BigBoatEnergy/BoatCAD/README.md

# Boat Robot

Robot Boats are hard. this may help someone.

-keith
