BigBoatEnergy/BoatCAD/cad/README.md

# CAD Files for Boat Robot

This contains all the models and STLs for the various parts printed during the
project.
