BigBoatEnergy/BoatCAD/cad/hull/README.md

# Hull Prototype

Prototype hull that we originally thought about printing, but decided against due to exorbitant cost.
