BigBoatEnergy/BoatCAD/cad/foam_model_mockup/foam plank dowel holders - main holders.stl

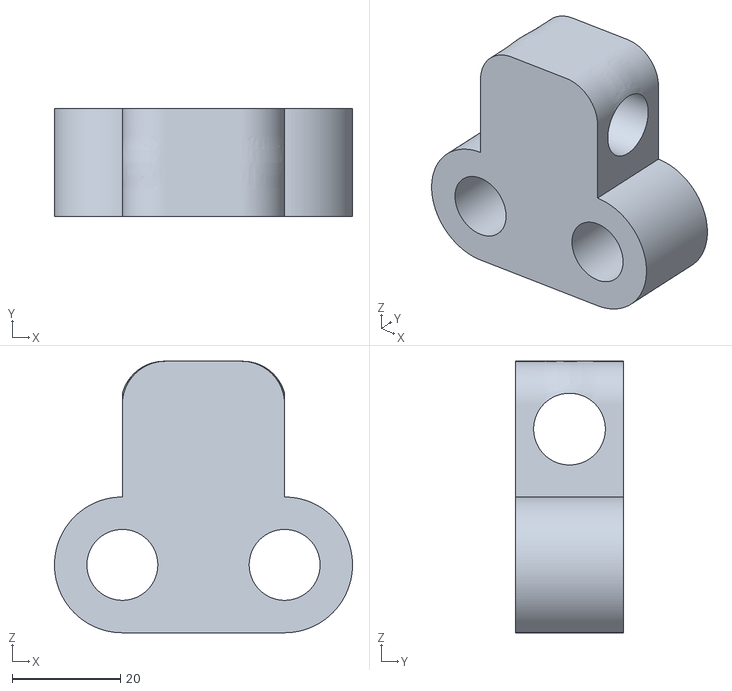
[picture p1: CAD file, 2023-07-22]
cad/foam_model_mockup/foam plank dowel holders - main holders.stl
55.1 x 20.0 x 50.2
