BigBoatEnergy/BoatCAD/cad/Antena_Slew_Ring/Antenna Slew Ring-Shaft Mounted Gearshaft mount.stl

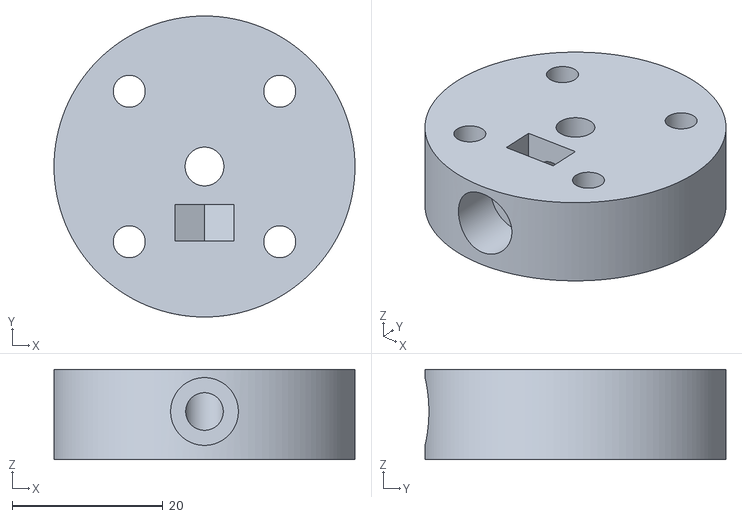
[picture p2: CAD file, 2024-01-04]
cad/Antena_Slew_Ring/Antenna Slew Ring-Shaft Mounted Gearshaft mount.stl
40.0 x 40.0 x 12.0
