BigBoatEnergy/BoatCAD/cad/beaglebone_blue/beaglebone Blue to pelican case.stl

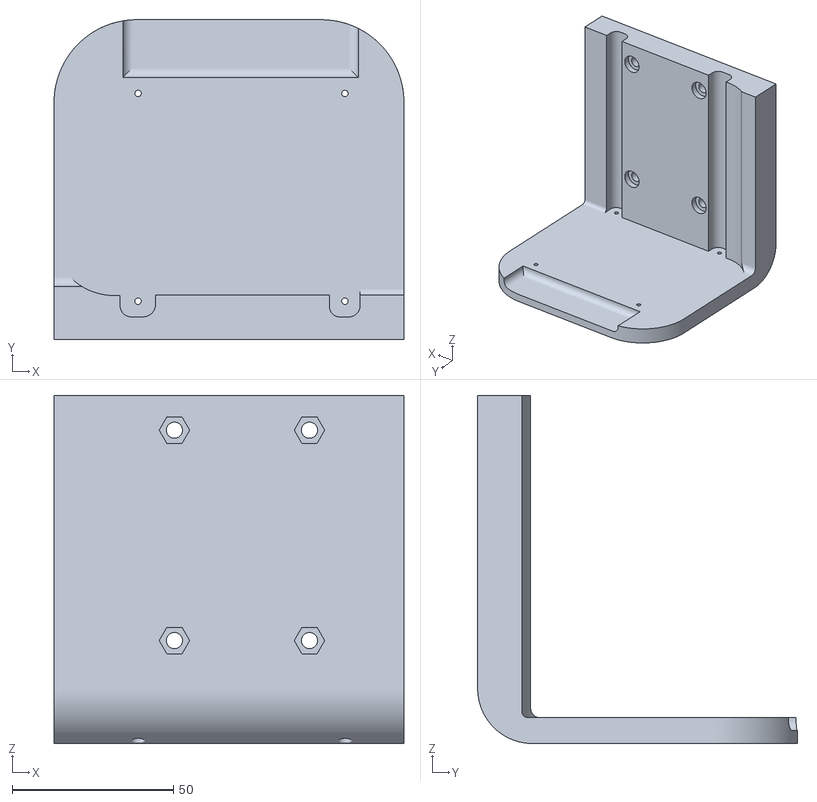
[picture p3: CAD file, 2023-07-22]
cad/beaglebone_blue/beaglebone Blue to pelican case.stl
108.6 x 99.2 x 108.0
