BigBoatEnergy/BoatCAD/cad/beaglebone_blue/beaglebone_blue_case/beaglebone Blue Case.FCStd

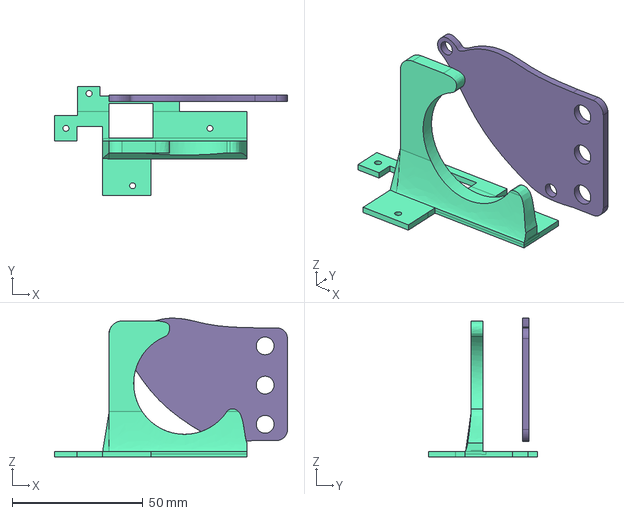
[picture p4: CAD file, 2023-07-17]
cad/beaglebone_blue/beaglebone_blue_case/beaglebone Blue Case.FCStd
89.1 x 41.7 x 53.1 mm
fan holder corrected
Antena Holder
