BigBoatEnergy/BoatCAD/cad/dowel_holder/Dowel holder-top dowel mount.stl

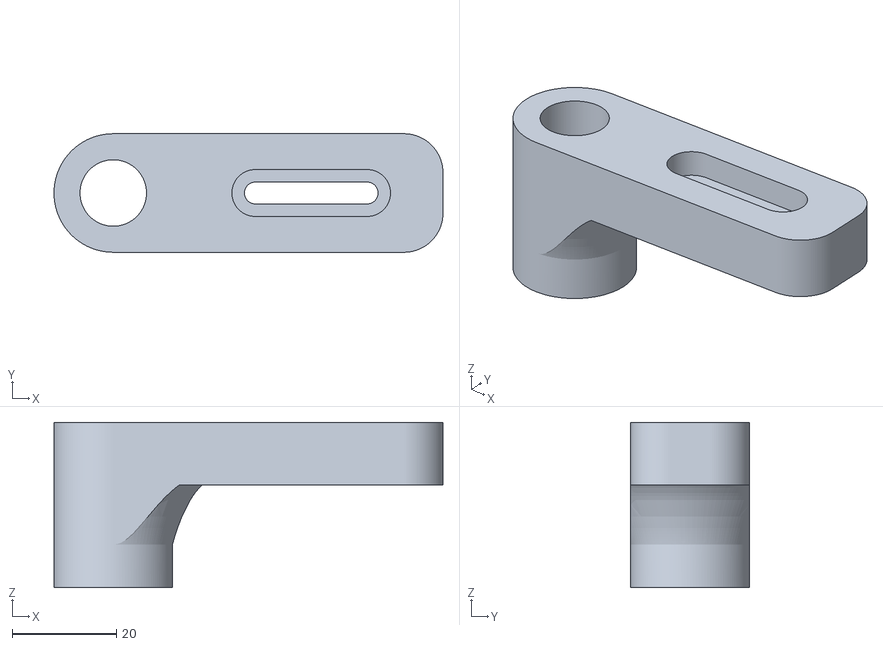
[picture p5: CAD file, 2023-07-14]
cad/dowel_holder/Dowel holder-top dowel mount.stl
74.6 x 22.8 x 31.8
