BigBoatEnergy/BoatCAD/cad/foam_model_mockup/foam plank dowel holders.FCStd

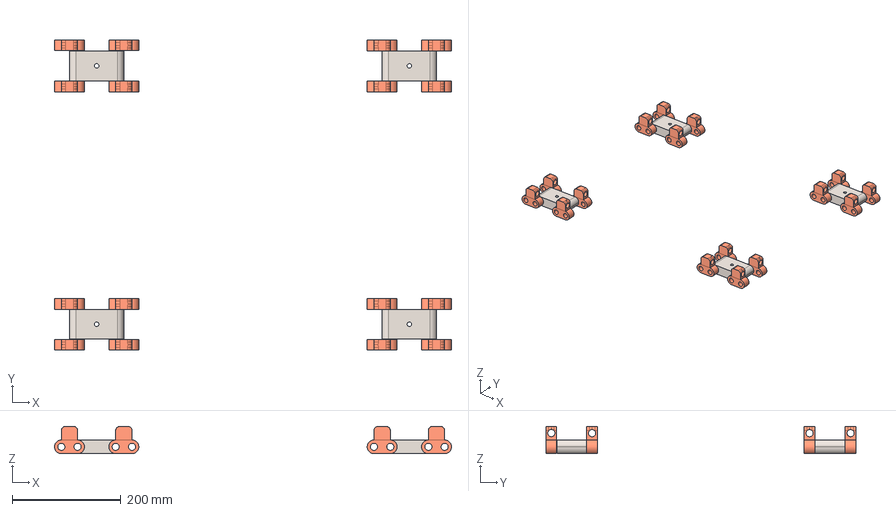
[picture p6: CAD file, 2023-07-22]
cad/foam_model_mockup/foam plank dowel holders.FCStd
730.1 x 570.6 x 50.2 mm
main mount points
ready rod adapters
