BigBoatEnergy/BoatCAD/cad/Heat Sync adapter plate/Heat sync adapter.FCStd

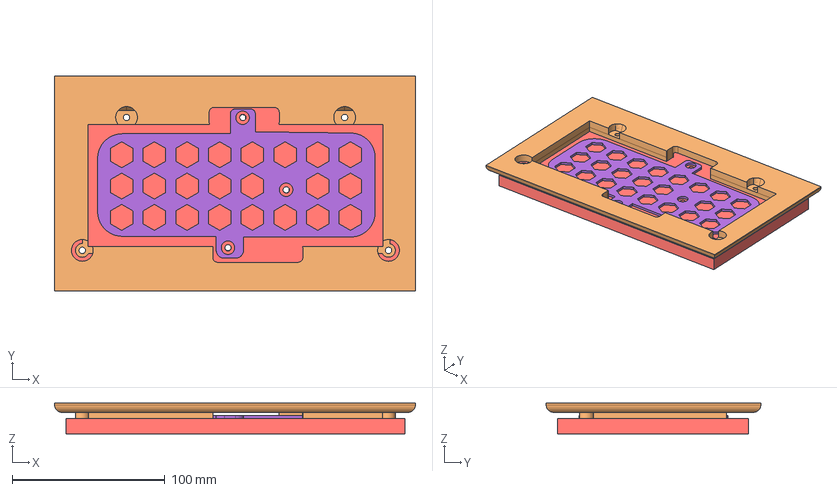
[picture p7: CAD file, 2024-01-04]
cad/Heat Sync adapter plate/Heat sync adapter.FCStd
236.4 x 140.6 x 20.0 mm
blank heat sync
esc hold down
