BigBoatEnergy/BoatCAD/cad/hull/boatymcrobotface.FCStd

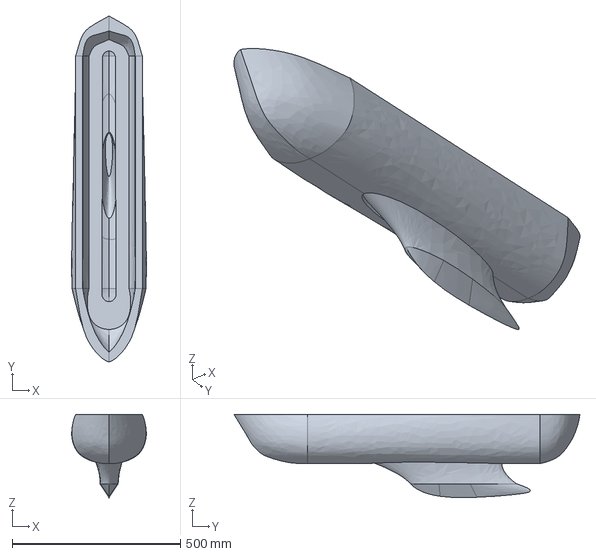
[picture p8: CAD file, 2023-07-14]
cad/hull/boatymcrobotface.FCStd
221.7 x 1028.0 x 247.2 mm
