BigBoatEnergy/BoatCAD/cad/pixhawk propper orientation fix/base.stl

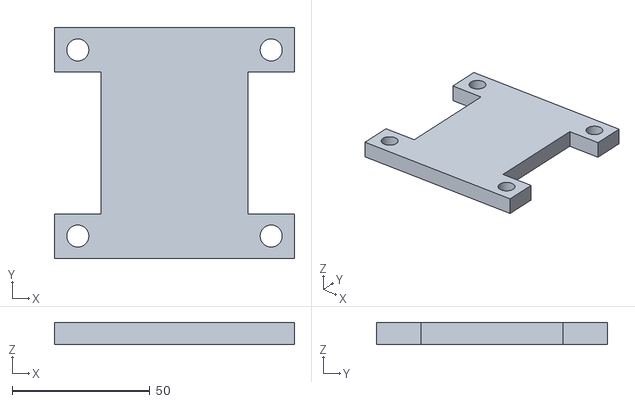
[picture p9: CAD file, 2024-01-04]
cad/pixhawk propper orientation fix/base.stl
87.2 x 83.8 x 8.00
