BigBoatEnergy/BoatCAD/cad/servo_motor_interface/Servo motor interface-mount to hull.stl

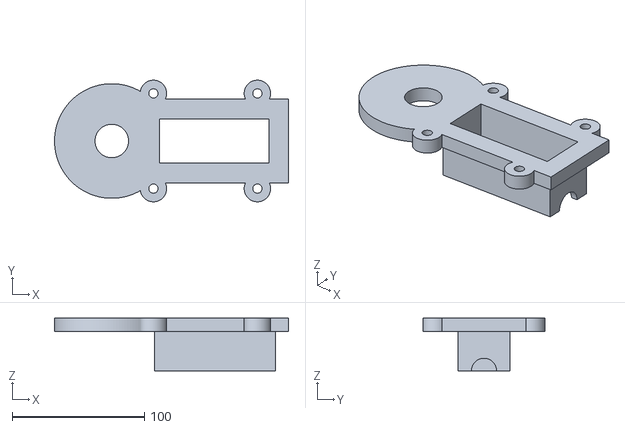
[picture p10: CAD file, 2023-07-22]
cad/servo_motor_interface/Servo motor interface-mount to hull.stl
177.2 x 92.1 x 40.0
