BigBoatEnergy/BoatCAD/Servo motor interface.FCStd

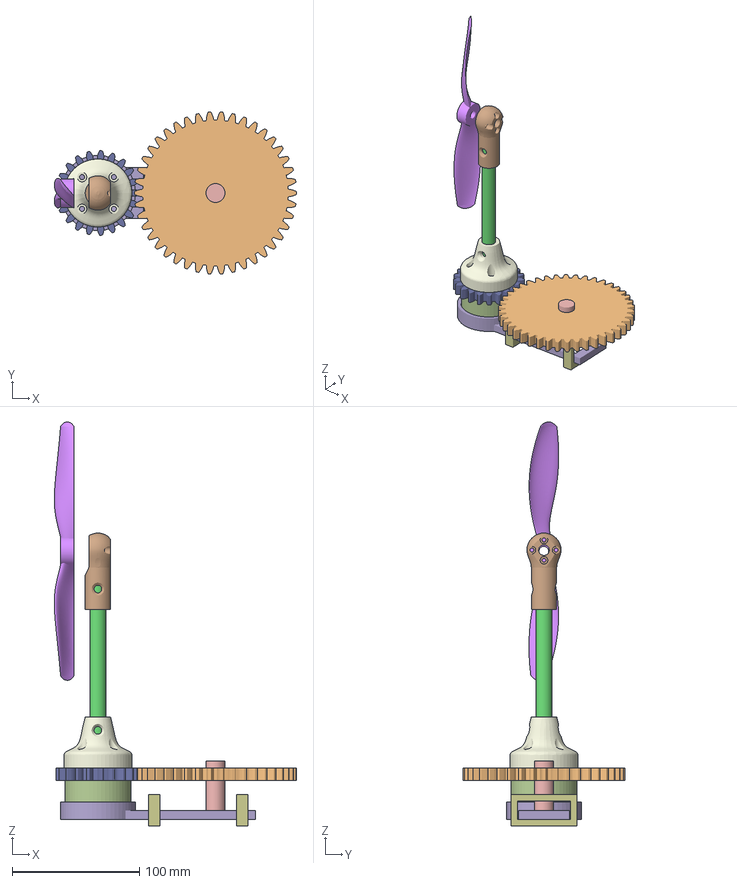
[picture p11: CAD file, 2023-07-15]
Servo motor interface.FCStd
190.4 x 127.4 x 317.5 mm
DRIVE GEAR
DRIVEN GEAR
BASE
TOP
brushless motor holder
propeller
