BigBoatEnergy/BoatCAD/cad/Antena_Slew_Ring/Antenna Slew Ring-bottom bearing body.stl

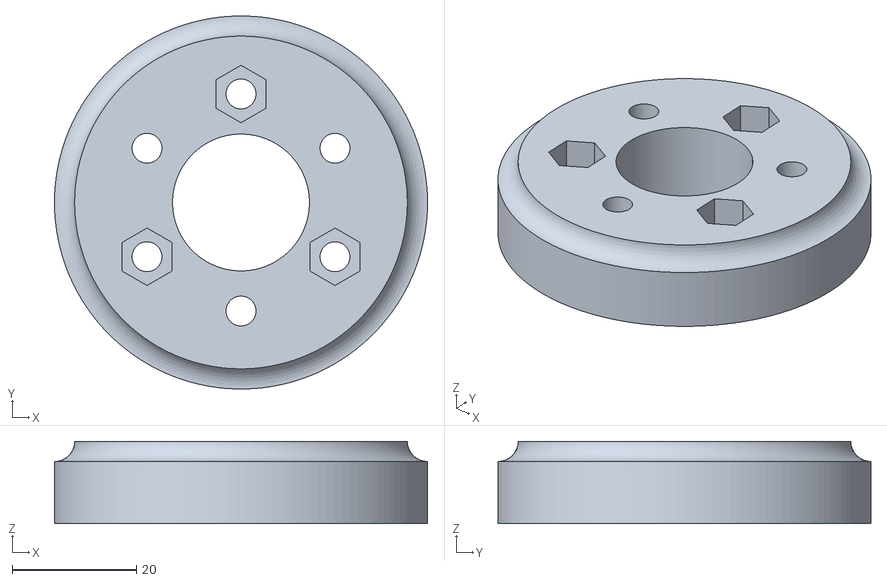
[picture p12: CAD file, 2024-01-04]
cad/Antena_Slew_Ring/Antenna Slew Ring-bottom bearing body.stl
60.0 x 60.0 x 13.3
