BigBoatEnergy/BoatCAD/cad/beaglebone_blue/beaglebone Blue Case-lid.stl

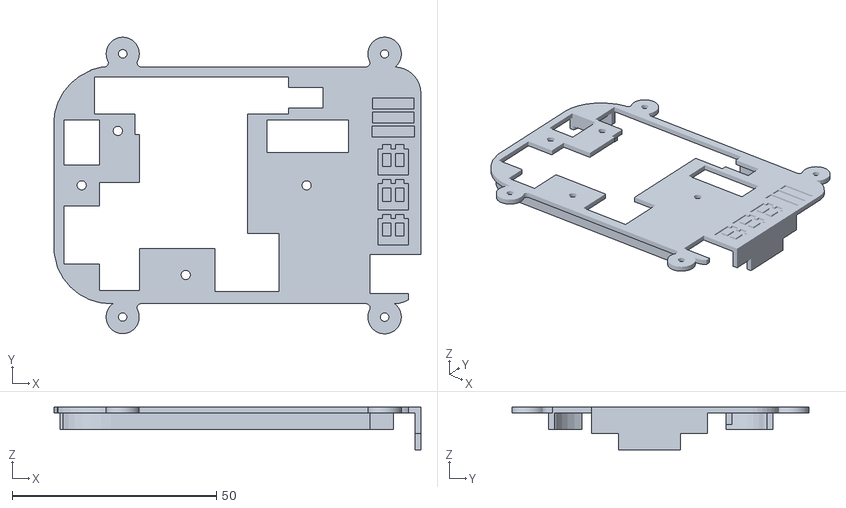
[picture p13: CAD file, 2023-07-17]
cad/beaglebone_blue/beaglebone Blue Case-lid.stl
89.9 x 72.7 x 10.5
