BigBoatEnergy/BoatCAD/cad/dowel_holder/Dowel holder.FCStd

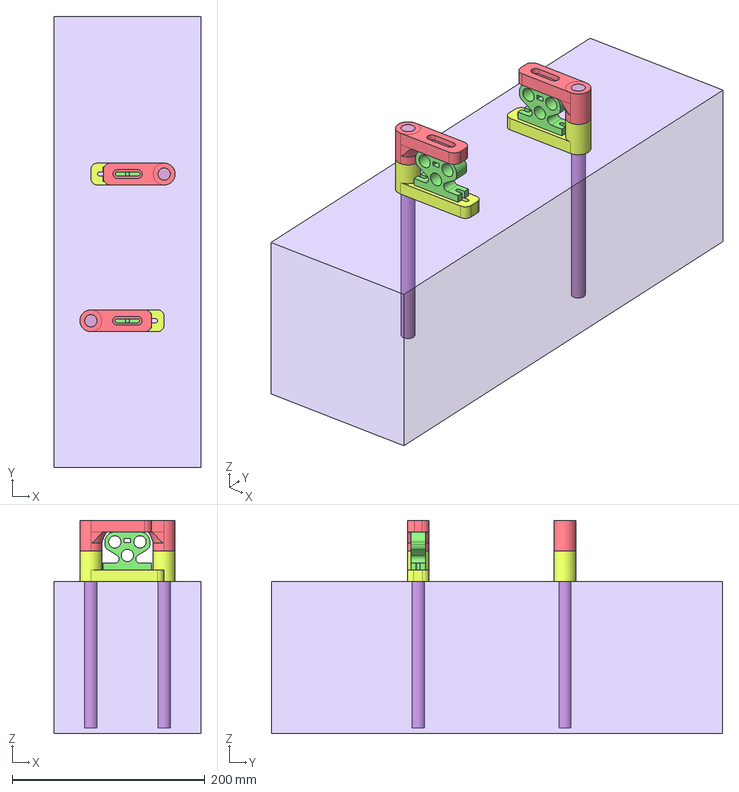
[picture p14: CAD file, 2023-07-14]
cad/dowel_holder/Dowel holder.FCStd
152.4 x 468.4 x 221.5 mm
Support dowel 1
boat hull mock up
Support dowel 2
top dowel mount
bottom dowel mount
3 rod holder
3 rod holder001
top dowel mount001
bottom dowel mount001
