BigBoatEnergy/BoatCAD/cad/foam_model_mockup/foam plank dowel holders - ready rod adapters.stl

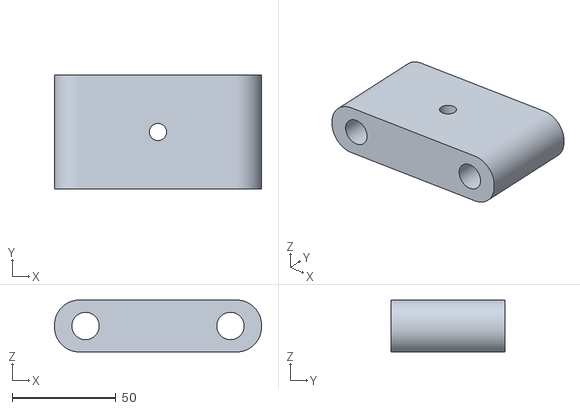
[picture p15: CAD file, 2023-07-22]
cad/foam_model_mockup/foam plank dowel holders - ready rod adapters.stl
100.0 x 55.1 x 25.1
