BigBoatEnergy/BoatCAD/cad/pixhawk propper orientation fix/top.stl

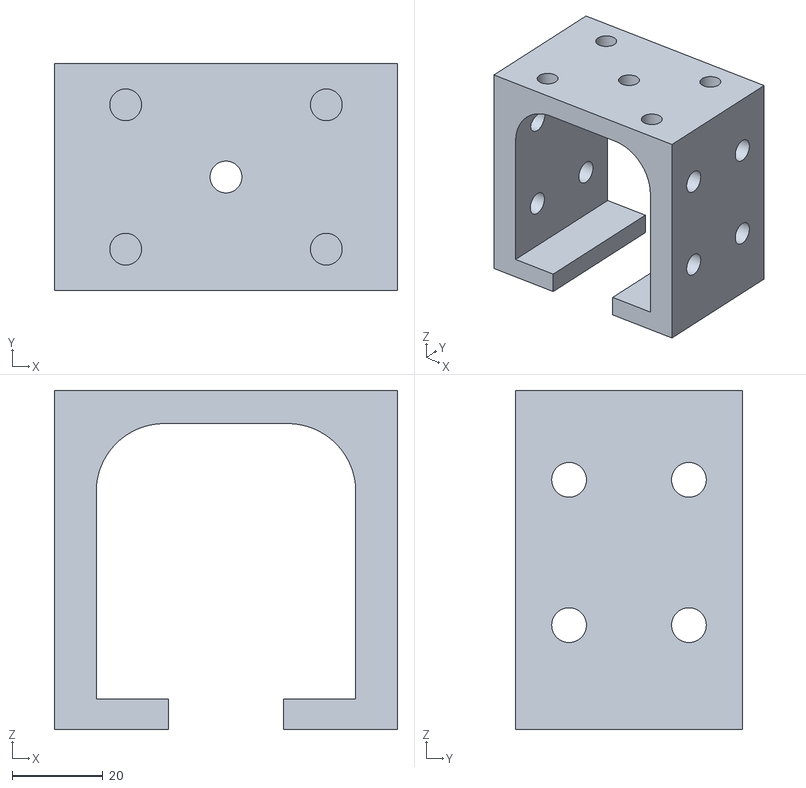
[picture p16: CAD file, 2024-01-04]
cad/pixhawk propper orientation fix/top.stl
75.5 x 50.0 x 74.7
