BigBoatEnergy/BoatCAD/cad/servo_motor_interface/Servo motor interface-brushless motor holder.stl

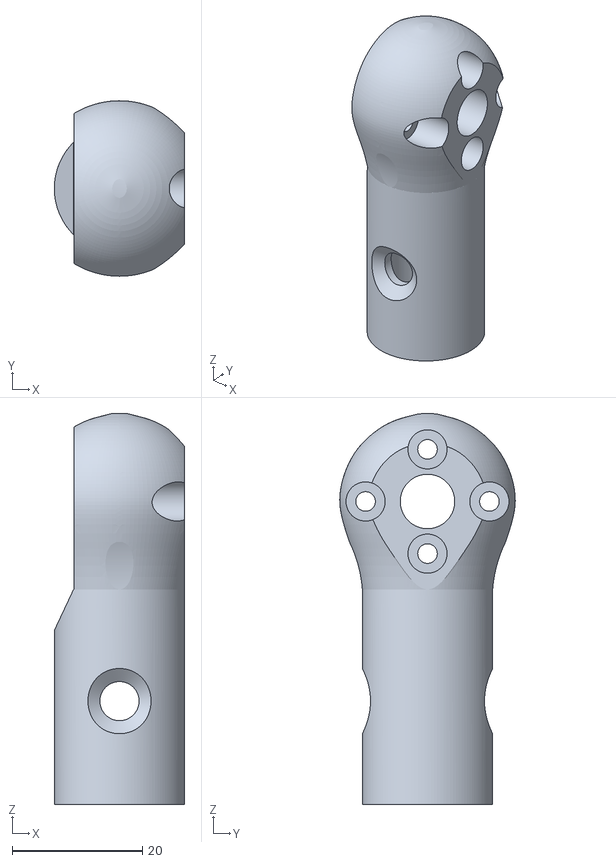
[picture p17: CAD file, 2023-07-17]
cad/servo_motor_interface/Servo motor interface-brushless motor holder.stl
20.0 x 26.9 x 60.0
