BigBoatEnergy/BoatCAD/cad/Antena_Slew_Ring/Antenna Slew Ring-base and side cover.stl

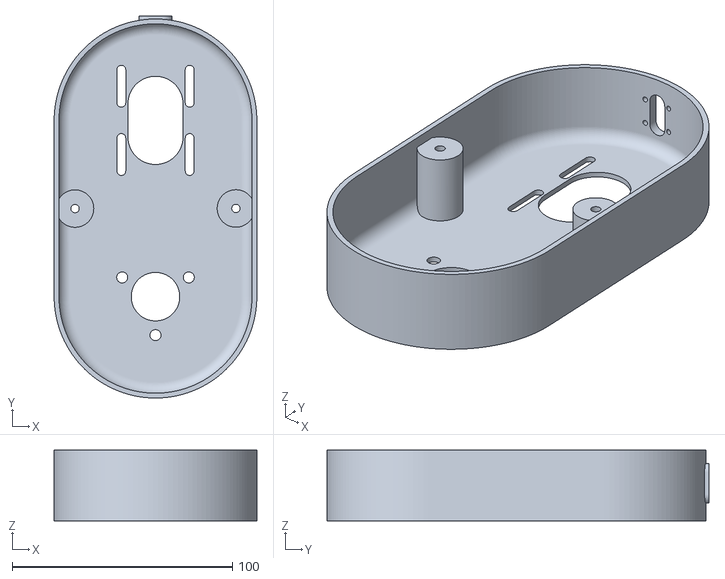
[picture p18: CAD file, 2024-01-04]
cad/Antena_Slew_Ring/Antenna Slew Ring-base and side cover.stl
92.0 x 173.4 x 32.0
