BigBoatEnergy/BoatCAD/cad/beaglebone_blue/beaglebone Blue Case-base.stl

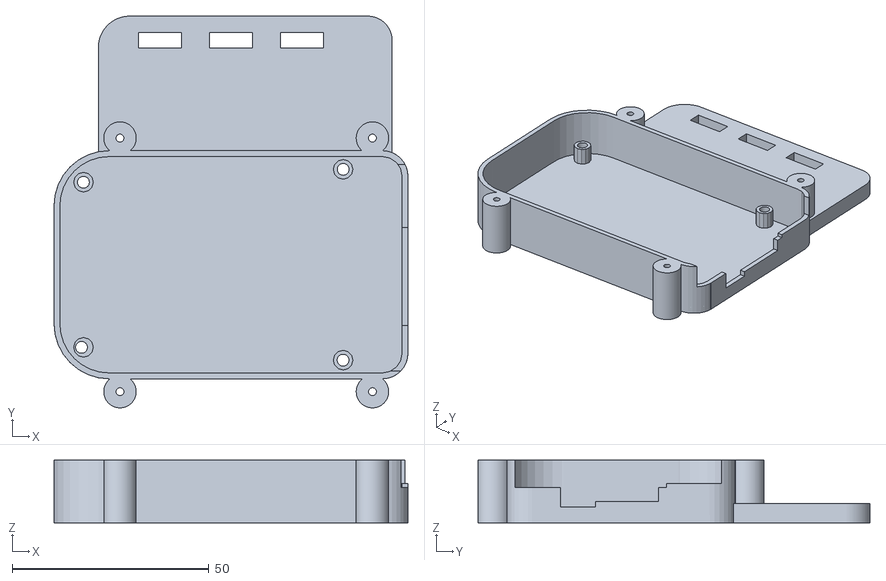
[picture p19: CAD file, 2023-07-17]
cad/beaglebone_blue/beaglebone Blue Case-base.stl
90.0 x 99.6 x 16.0
