BigBoatEnergy/BoatCAD/cad/dowel_holder/Dowel holder-3 rod holder.stl

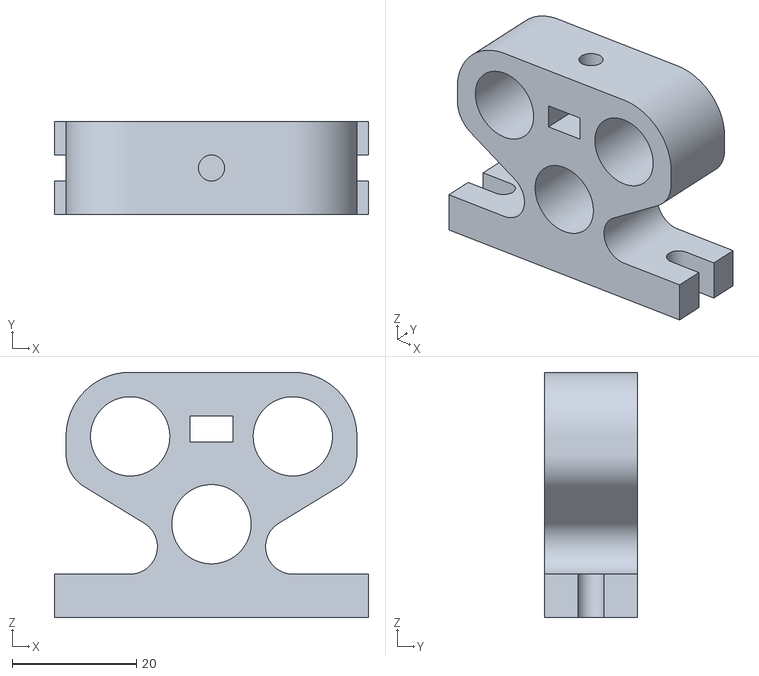
[picture p20: CAD file, 2023-07-14]
cad/dowel_holder/Dowel holder-3 rod holder.stl
50.5 x 15.0 x 39.5
