BigBoatEnergy/BoatCAD/cad/hull/boatymcrobotface-Fusion.stl

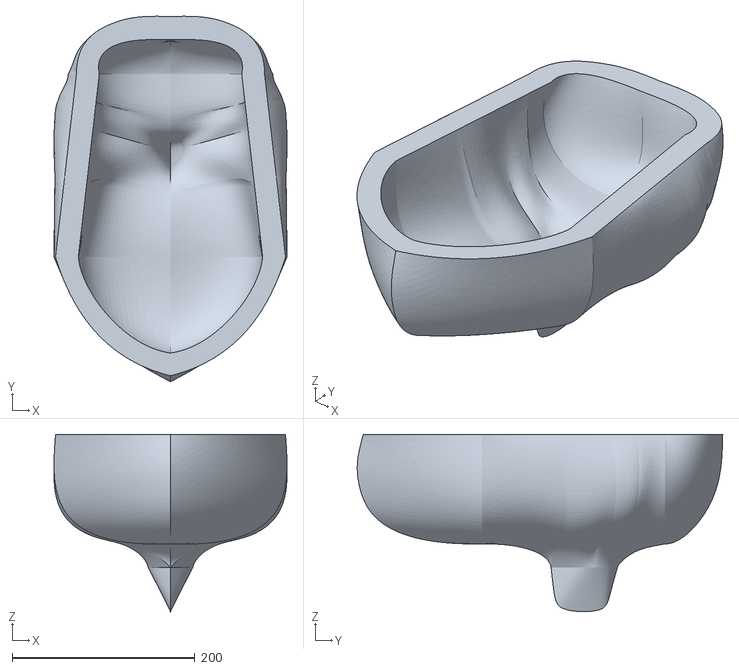
[picture p21: CAD file, 2023-07-01]
cad/hull/boatymcrobotface-Fusion.stl
254.9 x 399.9 x 193.9
