BigBoatEnergy/BoatCAD/cad/pixhawk propper orientation fix/orientation fix.FCStd

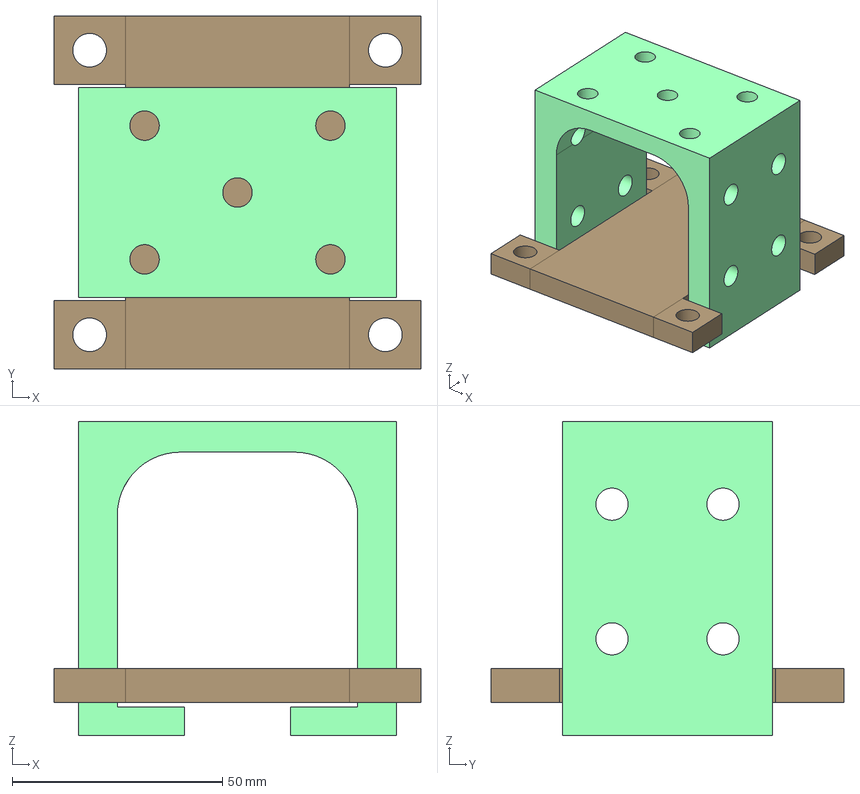
[picture p22: CAD file, 2024-01-04]
cad/pixhawk propper orientation fix/orientation fix.FCStd
87.2 x 83.8 x 74.7 mm
