BigBoatEnergy/BoatCAD/cad/servo_motor_interface/Servo motor interface-servo holder.stl

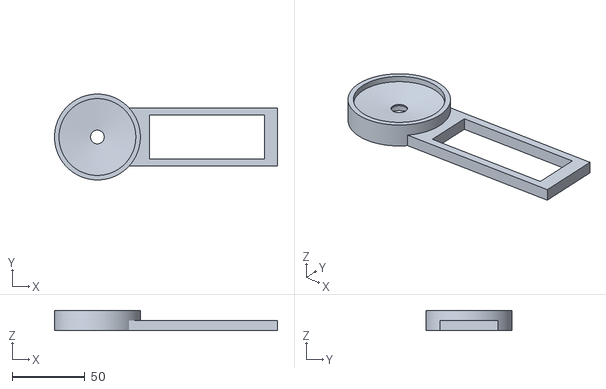
[picture p23: CAD file, 2023-07-15]
cad/servo_motor_interface/Servo motor interface-servo holder.stl
153.4 x 59.1 x 13.9
