BigBoatEnergy/BoatCAD/cad/Antena_Slew_Ring/Antenna Slew Ring-driven gear.stl

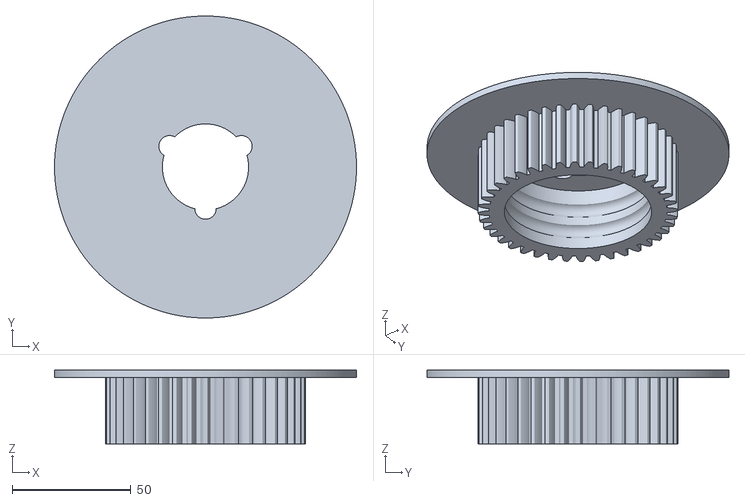
[picture p24: CAD file, 2024-01-04]
cad/Antena_Slew_Ring/Antenna Slew Ring-driven gear.stl
127.1 x 127.1 x 31.0
