BigBoatEnergy/BoatCAD/cad/beaglebone_blue/beaglebone Blue Case-antenna holder.stl

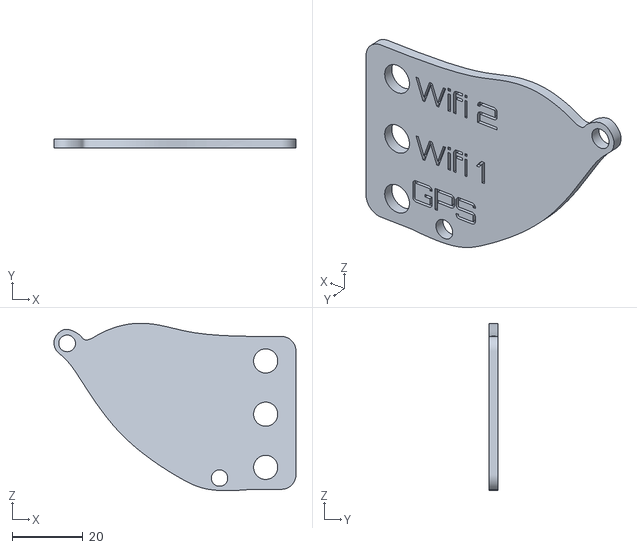
[picture p25: CAD file, 2023-07-17]
cad/beaglebone_blue/beaglebone Blue Case-antenna holder.stl
68.2 x 2.50 x 47.2
