BigBoatEnergy/BoatCAD/cad/dowel_holder/Dowel holder-bottom dowel mount.stl

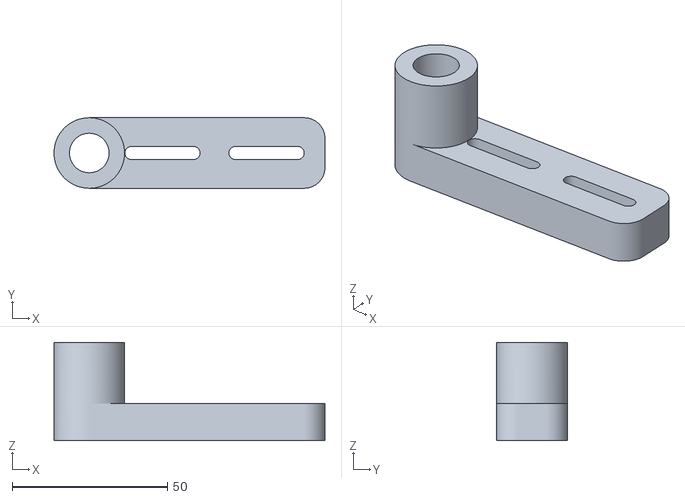
[picture p26: CAD file, 2023-07-14]
cad/dowel_holder/Dowel holder-bottom dowel mount.stl
87.4 x 22.8 x 31.8
