BigBoatEnergy/BoatCAD/cad/foam_model_mockup/foam model mockup.FCStd

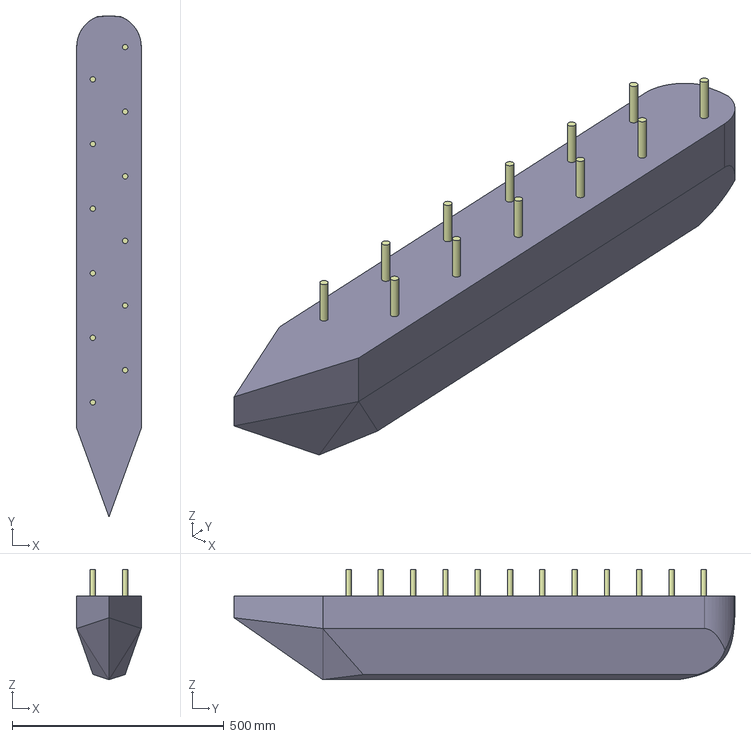
[picture p27: CAD file, 2023-07-14]
cad/foam_model_mockup/foam model mockup.FCStd
152.4 x 1181.7 x 260.4 mm
