BigBoatEnergy/BoatCAD/cad/servo_motor_interface/Servo motor interface-TOP.stl

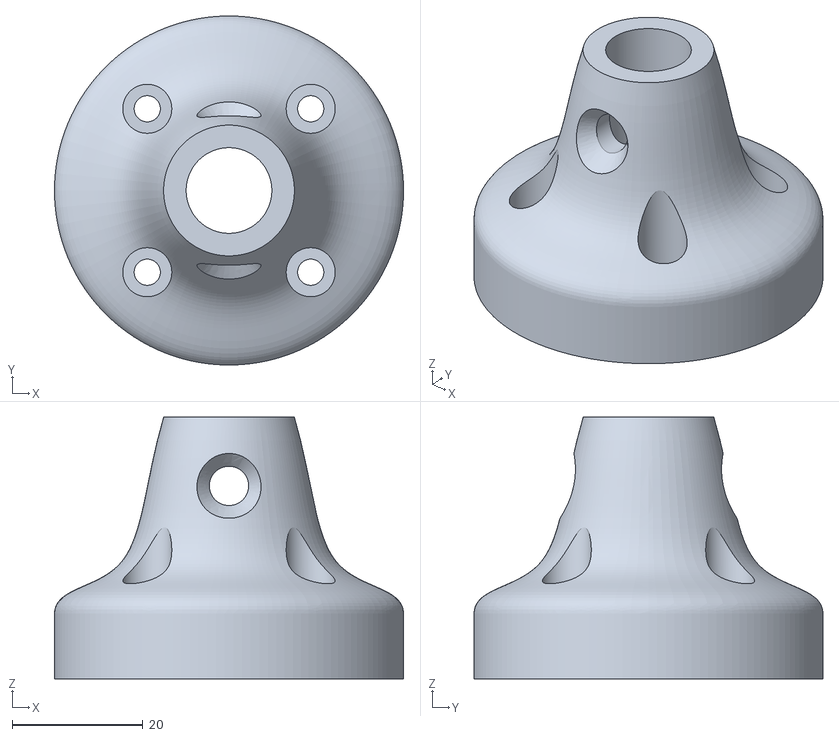
[picture p28: CAD file, 2023-07-15]
cad/servo_motor_interface/Servo motor interface-TOP.stl
53.4 x 53.4 x 40.0
