BigBoatEnergy/BoatCAD/cad/Antena_Slew_Ring/Antenna Slew Ring-Shaft Mounted GearGear.stl

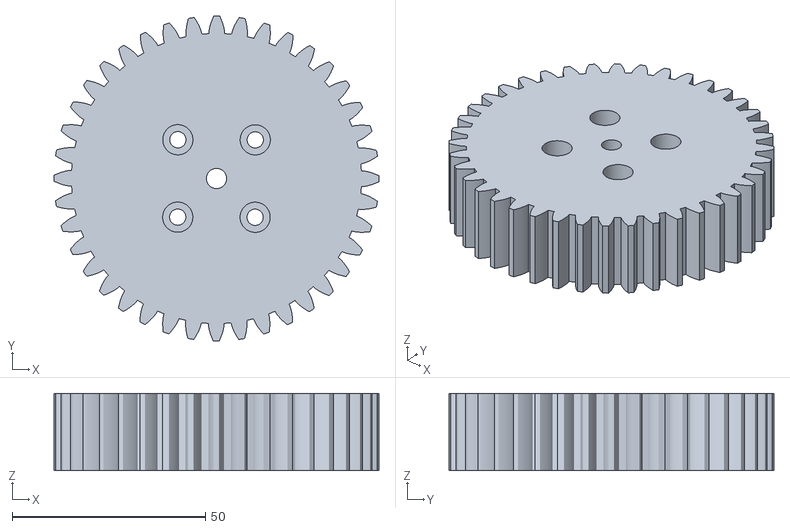
[picture p29: CAD file, 2024-01-04]
cad/Antena_Slew_Ring/Antenna Slew Ring-Shaft Mounted GearGear.stl
84.0 x 84.0 x 20.0
