BigBoatEnergy/BoatCAD/cad/beaglebone_blue/beaglebone Blue Case-fan holder.stl

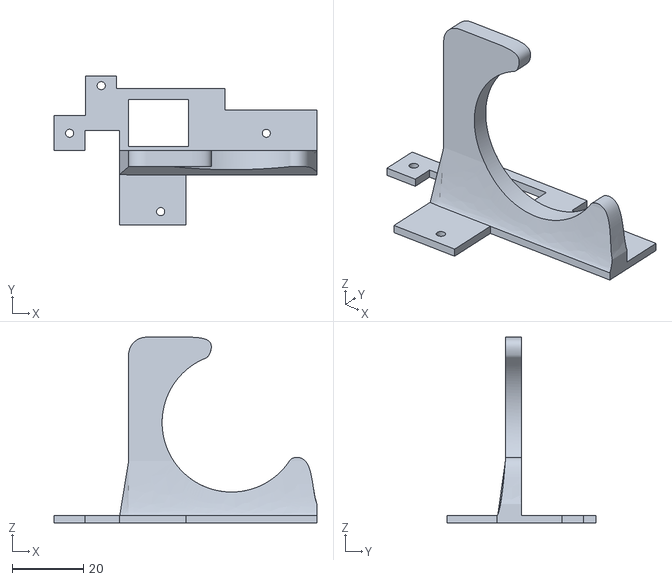
[picture p30: CAD file, 2023-07-17]
cad/beaglebone_blue/beaglebone Blue Case-fan holder.stl
73.7 x 41.7 x 52.0
