BigBoatEnergy/BoatCAD/cad/servo_motor_interface/Servo motor interface-DRIVEN GEAR.stl

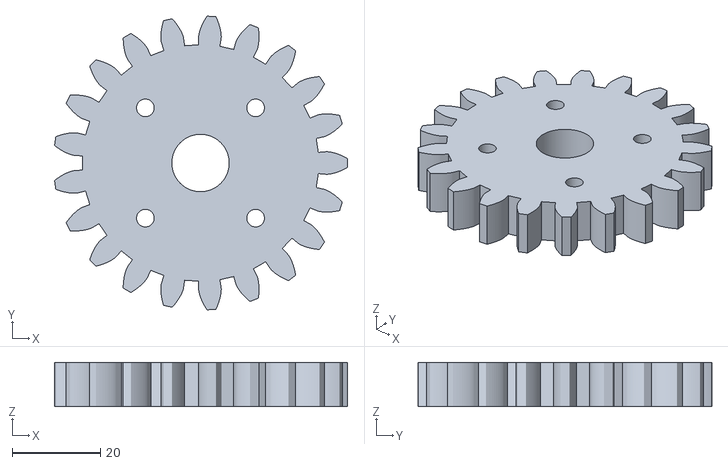
[picture p31: CAD file, 2023-07-15]
cad/servo_motor_interface/Servo motor interface-DRIVEN GEAR.stl
66.4 x 66.6 x 10.0
