BigBoatEnergy/BoatCAD/cad/Antena_Slew_Ring/Antenna Slew Ring.FCStd

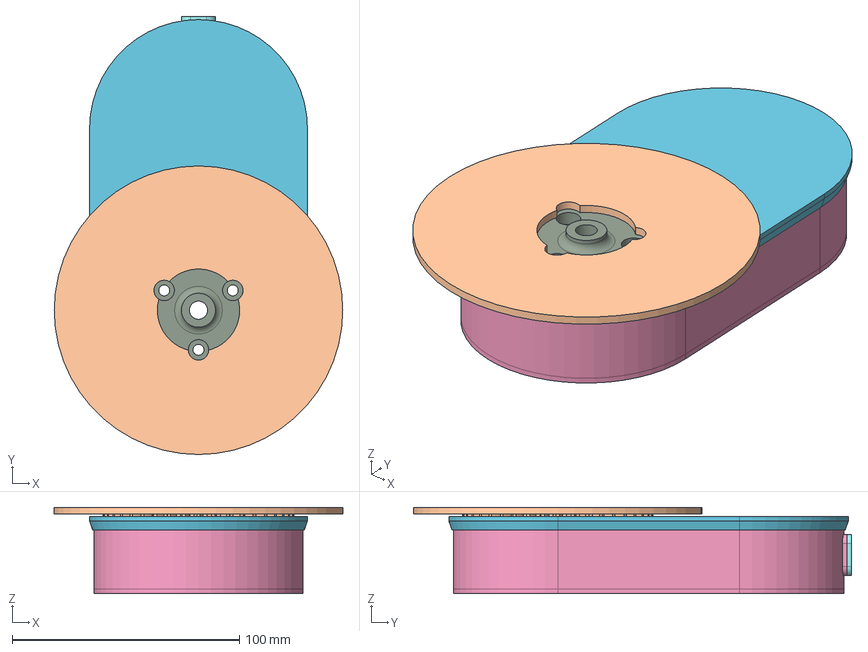
[picture p32: CAD file, 2024-01-04]
cad/Antena_Slew_Ring/Antenna Slew Ring.FCStd
127.1 x 192.9 x 38.0 mm
bottom bearing body
mid bearing body
top bearing body
driven gear
shaft mount
M4-Nut x 2
M4-Nut013 x 2
M4-Nut016 x 2
M4-Nut017 x 2
M5x12-Screw x 2
M5-Nut x 2
M4x16-Screw x 2
M4x16-Screw006 x 2
M4x16-Screw005 x 2
M4x16-Screw004 x 2
Gear x 2
base and side cover
Lid
allen bolt cover
