BigBoatEnergy/BoatCAD/cad/servo_motor_interface/Servo motor interface-BASE.stl

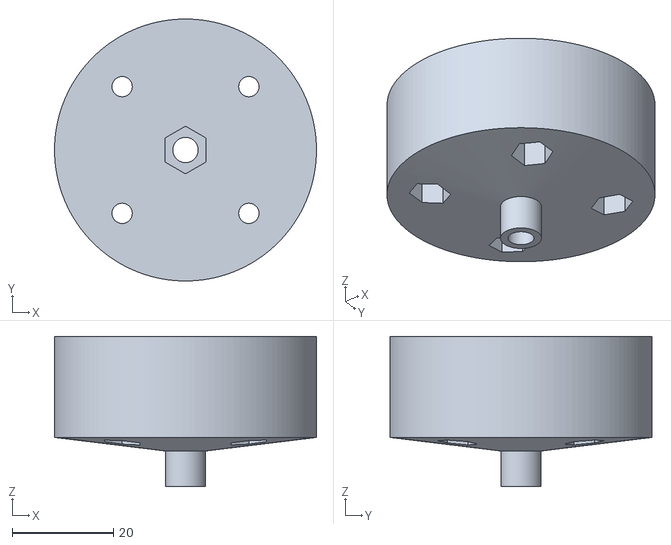
[picture p33: CAD file, 2023-07-15]
cad/servo_motor_interface/Servo motor interface-BASE.stl
51.7 x 51.7 x 29.6
