BigBoatEnergy/BoatCAD/cad/Antena_Slew_Ring/Antenna Slew Ring-mid bearing body.stl

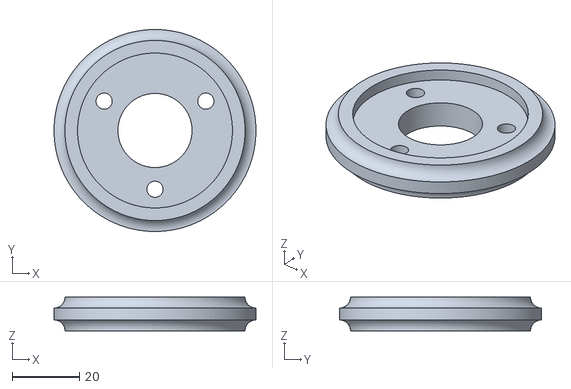
[picture p34: CAD file, 2024-01-04]
cad/Antena_Slew_Ring/Antenna Slew Ring-mid bearing body.stl
60.0 x 60.0 x 10.0
