BigBoatEnergy/BoatCAD/cad/servo_motor_interface/Servo motor interface-DRIVE GEAR.stl

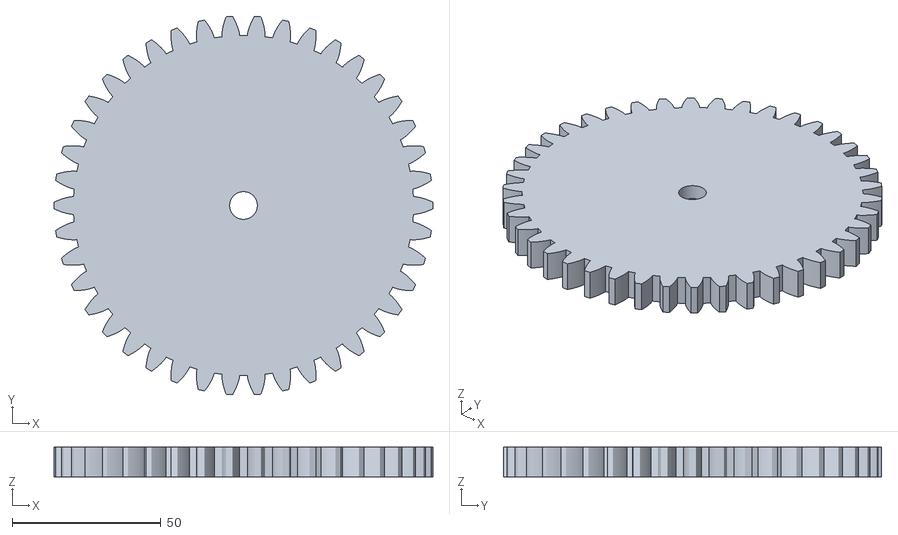
[picture p35: CAD file, 2023-07-15]
cad/servo_motor_interface/Servo motor interface-DRIVE GEAR.stl
127.6 x 127.4 x 10.0
