BigBoatEnergy/BoatCAD/cad/Antena_Slew_Ring/Antenna Slew Ring-Lid.stl

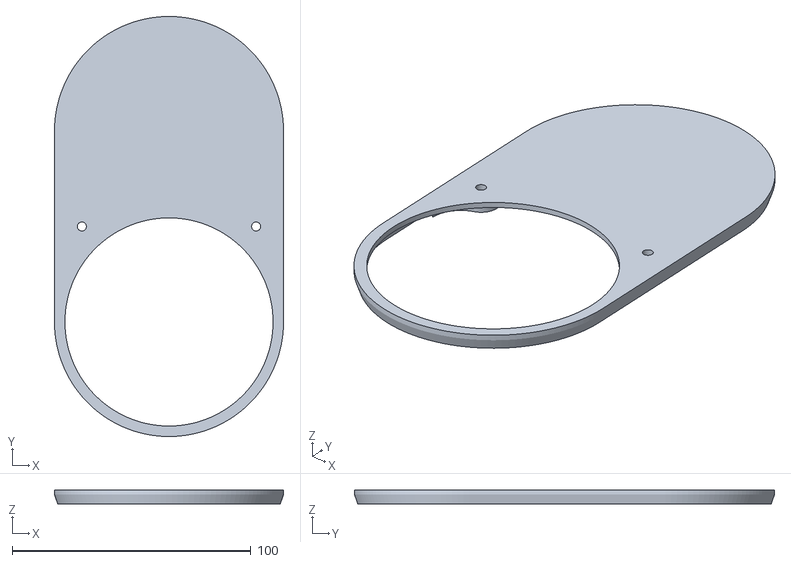
[picture p36: CAD file, 2024-01-04]
cad/Antena_Slew_Ring/Antenna Slew Ring-Lid.stl
96.0 x 176.0 x 6.00
