BigBoatEnergy/BoatCAD/cad/Antena_Slew_Ring/Antenna Slew Ring-top bearing body.stl

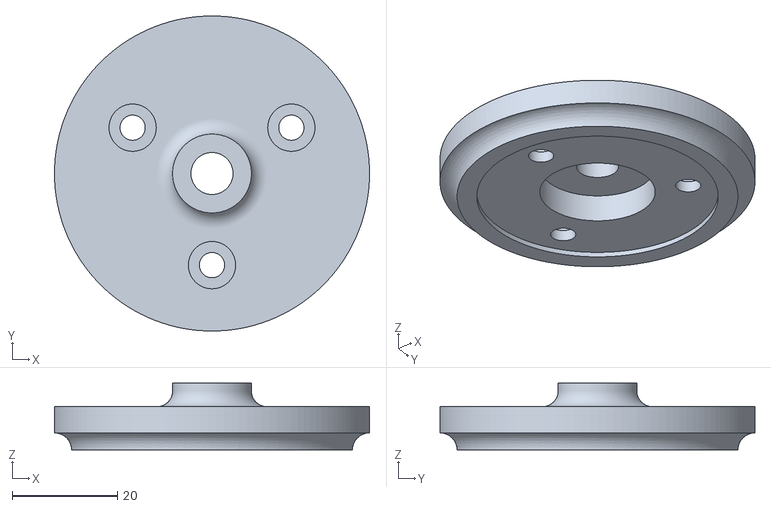
[picture p37: CAD file, 2024-01-04]
cad/Antena_Slew_Ring/Antenna Slew Ring-top bearing body.stl
60.0 x 60.0 x 12.8
