BigBoatEnergy/BoatCAD/(list of files, cad)

Other CAD files:
cad/hull/boatymcrobotface-with keel.stl
cad/Antena_Slew_Ring/Antenna Slew Ring-allen bolt cover.stl
cad/beaglebone_blue/beaglebone_blue_case/beaglebone Blue Case.stl
cad/bulkhead_connectors/Bulkhead connectors servos nut.stl
cad/servo_motor_interface/Servo motor interface-servo holder for bolts.stl
