BigBoatEnergy/BoatCAD/(commit log)

2023-07-01 3d model with new workflow
    [boatymcrobotface.FCStd]
2023-07-01 Lumpy version of boat
    [boatymcrobotface-Fusion.stl, boatymcrobotface.FCStd]
2023-07-02 Less Rubish shape
    [boatymcrobotface- non lumpy-Fusion002.stl, boatymcrobotface.FCStd]
2023-07-02 Keel attached
    [boatymcrobotface.FCStd]
2023-07-14 added a couple of files and initialised servo motor interface
    [Dowel holder-3 rod holder.stl, Dowel holder-bottom dowel mount.stl, Dowel holder-top dowel mount.stl, Dowel holder.FCStd, Servo motor interface.FCStd, boatymcrobotface-with keel.stl, boatymcrobotface.FCStd, foam model mockup.FCStd]
2023-07-15 stl models added, worked on servo interface
    [Servo motor interface-BASE.stl, Servo motor interface-DRIVE GEAR.stl, Servo motor interface-DRIVEN GEAR.stl, Servo motor interface-TOP.stl, Servo motor interface-brushless motor holder.stl, Servo motor interface-servo holder for bolts.stl, Servo motor interface-servo holder.stl, Servo motor interface.FCStd]
2023-07-17 added beagle bone blue case and bulkhead connectors models
    [Bulkhead connectors servos nut.stl, Servo motor interface-brushless motor holder.stl, beaglebone Blue Case-antenna holder.stl, beaglebone Blue Case-base.stl, beaglebone Blue Case-fan holder.stl, beaglebone Blue Case-lid.stl, beaglebone Blue Case.FCStd, beaglebone Blue Case.stl]
2023-07-22 Add some folder organization
    [Bulkhead connectors servos nut.stl, Dowel holder-3 rod holder.stl, Dowel holder-bottom dowel mount.stl, Dowel holder-top dowel mount.stl, Dowel holder.FCStd, Servo motor interface-BASE.stl, Servo motor interface-DRIVE GEAR.stl, Servo motor interface-DRIVEN GEAR.stl]
2023-07-22 re-orgainzed and added CAD files
    [Servo motor interface-mount to hull.stl, beaglebone Blue to pelican case.stl, foam plank dowel holders - main holders.stl, foam plank dowel holders - ready rod adapters.stl, foam plank dowel holders.FCStd]
2024-01-04 Added cad files
    [Antenna Slew Ring-Lid.stl, Antenna Slew Ring-Shaft Mounted GearGear.stl, Antenna Slew Ring-Shaft Mounted Gearshaft mount.stl, Antenna Slew Ring-allen bolt cover.stl, Antenna Slew Ring-base and side cover.stl, Antenna Slew Ring-bottom bearing body.stl, Antenna Slew Ring-driven gear.stl, Antenna Slew Ring-mid bearing body.stl]
